MehmetEralpKose/ISWT/Hardware Project/Materials for the Report/Fotos for simulations and test results/Test results/Power supply.jpeg

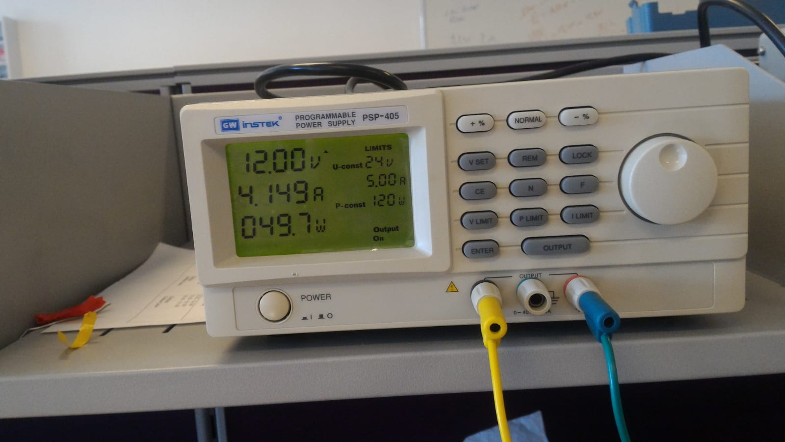
Hardware Project/Materials for the Report/Fotos for simulations and test results/Test results/Power supply.jpeg
