MehmetEralpKose/ISWT/Hardware Project/Materials for the Report/Fotos for simulations and test results/Test results/Vds for 10 ohm.jpeg

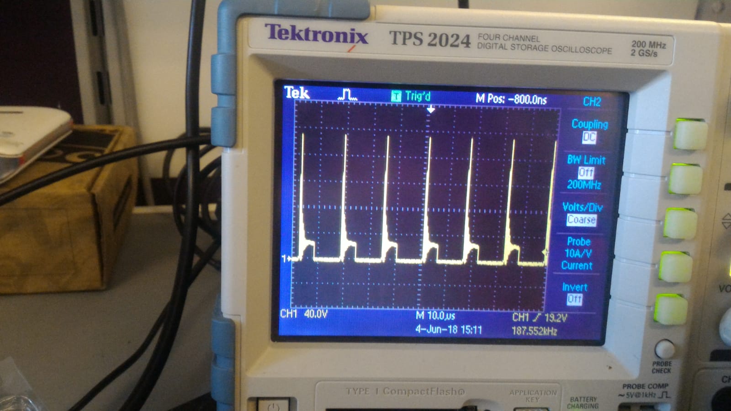
Hardware Project/Materials for the Report/Fotos for simulations and test results/Test results/Vds for 10 ohm.jpeg
