MehmetEralpKose/ISWT/README.md

# ISWT
2017-2018 Spring Term EE 464 Hardware Project Repository
