MehmetEralpKose/ISWT/Simulation Project/Transformer Design_1st version.docx

Transformer Design

We use 495-5251-ND as a core. Its material is N41.

Bsat is nearly 0.4T.


N1>(Vimax*Dmax*1/(fs))/(Bsat*Ae) (1)

From the equation (1) N1>2

Reluctance=(Le)/((µ*Ae)) (2)

R=0.2 Ω

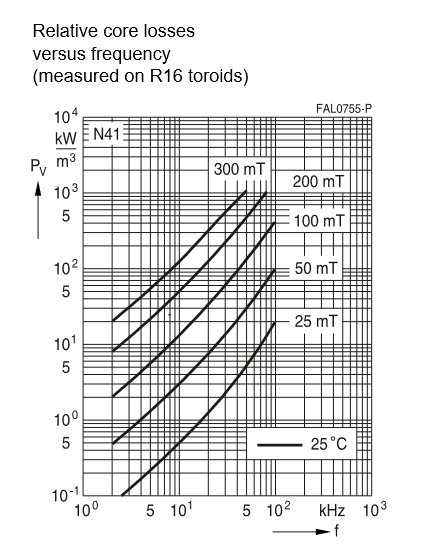
[picture p6: figure]
