MehmetEralpKose/ISWT/Simulation Project/1e.docx

e)


Figure 1: Input Current Waveform under Full-Load Operation

Power input during full load operation is,

, P_(in) =V_s *I_(input) #(1)

, P_(in) =12*17.795*0.4 #(2)

, P_(in) =85.416W #(3)

, efficiency=(P_(out))/(P_(in))=0.93 #(4)

, I_(out) =1.842A #(5)


Figure 2: Input Current Waveform under 75% Load Operation

Power input during full load operation is,

, P_(in) =V_s *I_(input) #(6)

, P_(in) =12*13.73*0.4 #(7)

, P_(in) =65.9W #(8)

, efficiency=(P_(out))/(P_(in))=0.91 #(9)

, I_(out) =1.229A #(10)


Figure 3: Input Current Waveform under 50% Load Operation

Power input during full load operation is,

, P_(in) =V_s *I_(input) #(11)

, P_(in) =12*9.67*0.4 #(12)

, P_(in) =46.416W#(13)

, efficiency=(P_(out))/(P_(in))=0.88 #(14)

, I_(out) =0.8192A #(15)


Figure 4: Input Current Waveform under 25% Load Operation

Power input during full load operation is,

, P_(in) =V_s *I_(input) #(16)

, P_(in) =12*5.42*0.4 #(17)

, P_(in) =26.016W#(18)

, efficiency=(P_(out))/(P_(in))=0.76 #(19)

, I_(out) =0.4079A #(20)

As expected, efficiency is decreased with decreasing load. Due to transformer used in flyback converter, transformer has low efficiency due to hysteresis losses (magnetization and demagnetization of transformer core) and eddy current at low load. Since at low load, these losses dominate the output power. Then the efficiency of the flyback converter is low under smaller loads. When load further increased efficiency will start to increase until its maximum level. Since also all of the components has finite resistance which caused power losses such as internal resistance of the switch, internal resistance of the capacitance etc.
