MehmetEralpKose/ISWT/Simulation Project/Q1-a_edition2.docx

a) , (V_o)/(V_d)=(N_2)/(N_1)*(D/(1-D))#(1)

Let’s assume D=0.4

, 48/12=(N_2)/(N_1)*(0.4/(1-0.4))#(2)

, (N_2)/(N_1)=6#(3)

To find Lm first find the average current flow in Lm

, I_(L_m) =(I_o)/((1-D))*(N_2)/(N_1)=((P_(out))/(V_(out)))/((1-D))*(N_2)/(N_1) #(4)

, I_(L_m) =16.1A #(5)

Now let’s assume, current ripple in the magnetization current is equal to 40%.

, ∆I_(L_m) =16.1*0.4≅6.4#(6)

, L_m =(V_d D)/(∆I_(L_m) f_s)#(7)

fs is taken as 100kHz,

, L_m =7.5μH #(8)

Lm is taken as 14.4 μH , which is explained in part b.

Then, the MATLAB Simulink simulations were done according to values which were found above.

Figure 1:Circuit Schematic of the Flyback Converter


Figure 2: Output Characteristic of the Flyback Converter


Figure 3: Current Flow Characteristic on the Diode


Figure 4: Magnetization Current Waveform of the Flyback Converter
