MehmetEralpKose/ISWT/Simulation Project/Q2/Transfer Function.docx

Q2)

TRANSFER FUNCTION OF FLYBACK CONVERTER


Figure 2.1: Flyback Converter Schematic


Figure 2.2: Small Signal Model of Flyback Converter

We choose n=1 and circuit schematic will be like that;


Figure 2.3: Switch ON State When n=1


Figure 2.4: Switch OFF State When n=1

By looking ON state:

-Vi+R_L *i_L +LiL=0 (1)

CVc*(R+rc)+Vc=0 (2)

By using Eq. (1) and (2)


By looking OFF state:

i_L *R_L +L*iL+R(i_L -C*Vc)=0 (3)

-Vc+R(i_L -C*Vc)-C*Vc*rc=0 (4)

By using Eq. (3) and (4)


V_0 =R(i_L -C*Vc) (5)

V0 = [ R*rc/(R+rc) , R/(R+rc)] [i_L Vc ] (6)

A=AON*D+AOFF*(1-D) (7)

B=BON*D+BOFF*(1-D) (8)

C=CON*D+COFF*(1-D) = [ R*rc/(R+rc) , R/(R+rc)] (10)

T(s)=(V_0)/(V_i)=-CA^(-1) B (11)

By using Eq. (7), (8), (9), (10) and (11),

T(s) is that form.


(12)

(n=turn ratio)

(13)

Where the frequency of negative pole:

(14)

And the frequency of negative pole:


(15)

Angular corner Frequency:

(16)

Damping Ratio:

(17)

Where,

(18)

(19)

(20)

Where,

Wzn=10⁵ rad/s,

Wzp=1580138.9 rad/s,

W0=15866 rad/s,

ξ= 0.3119,

Therefore,

T(s)=0.311*([(s+100000)*(s-1580138.9 )])/(s^2 +9896.25s+251729355.8)

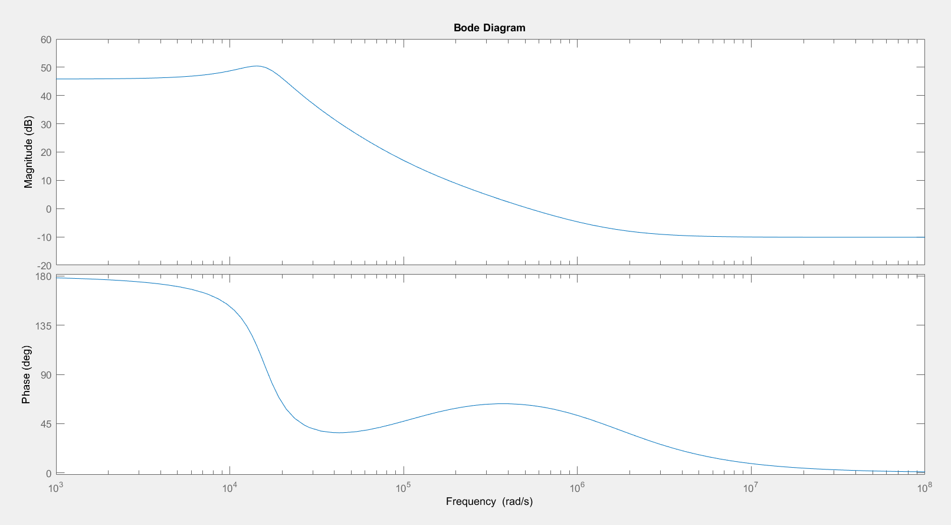
[picture p42: figure]

Bode Plot for 1:1 Turn Ratio

We will use 3:18 turn ratio so transfer function is modified for this turn ratio. Now, n=1/6 and

Wzn=10⁵ rad/s,

Wzp=428317.9 rad/s,

W0=2237.84 rad/s,

ξ= 0.677,

T(s)=0.05188*([(s+100000)*(s-428317.9 )])/(s^2 +3030*s+5007927.9)

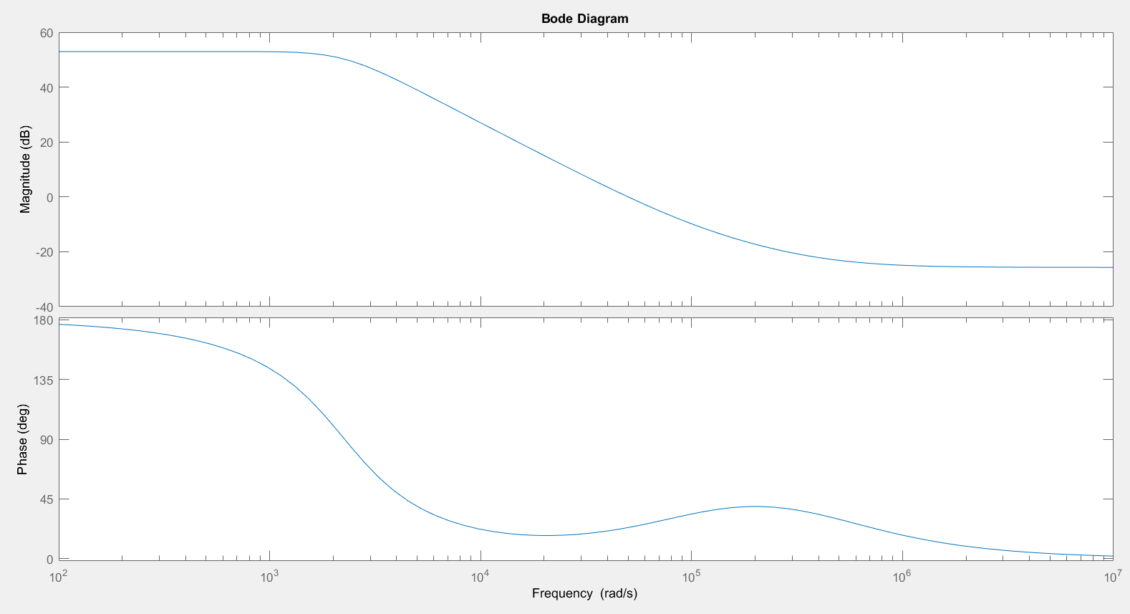
[picture p43: figure]

Bode Plot for 3:18 Turn Ratio
