MehmetEralpKose/ISWT/Simulation Project/Q1-c/25% Load.jpg

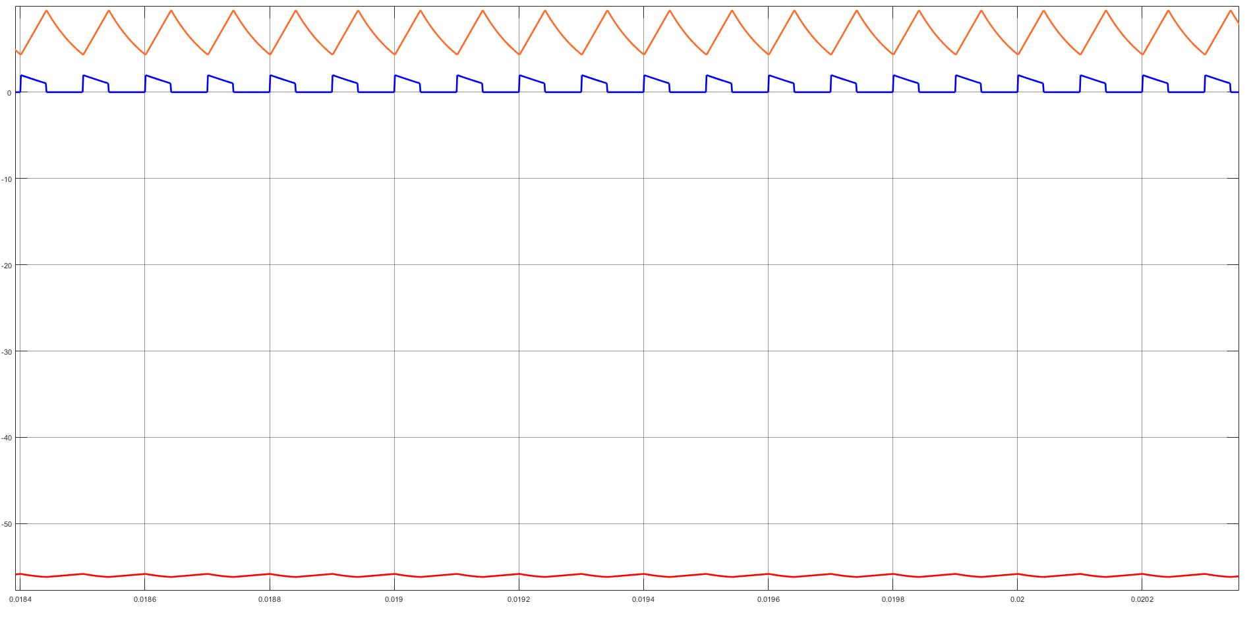
Simulation Project/Q1-c/25% Load.jpg
