MehmetEralpKose/ISWT/Simulation Project/Q1-c/50% load.jpg

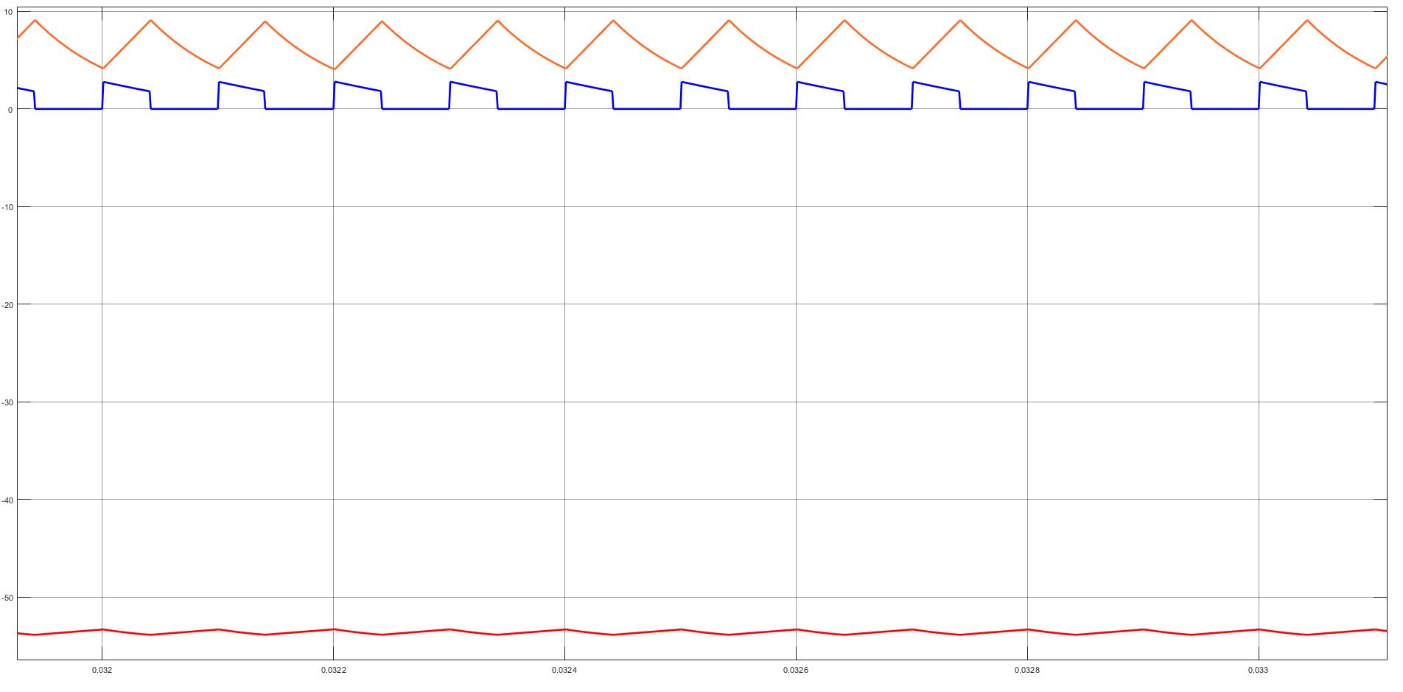
Simulation Project/Q1-c/50% load.jpg
