MehmetEralpKose/ISWT/Simulation Project/Q1-c/75% load.jpg

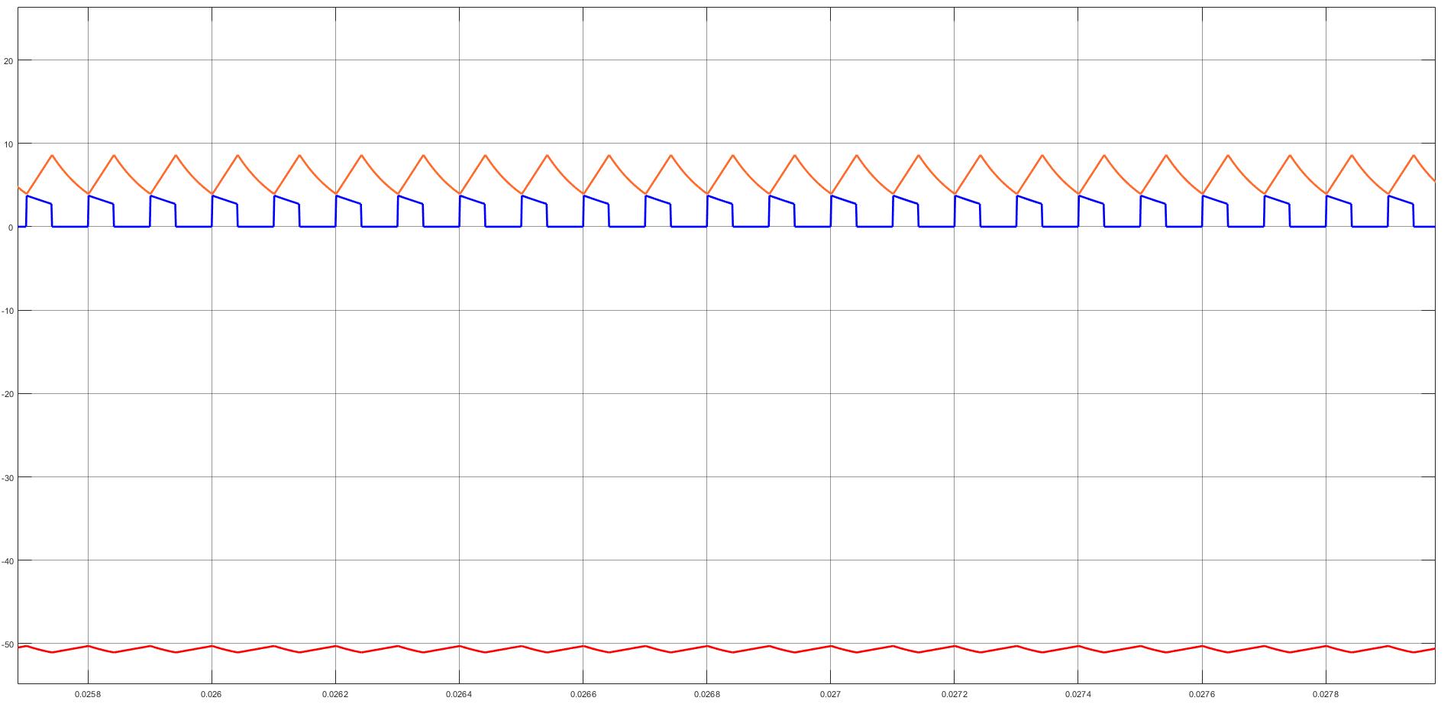
Simulation Project/Q1-c/75% load.jpg
