MehmetEralpKose/ISWT/Simulation Project/Q1-c/100% load.jpg

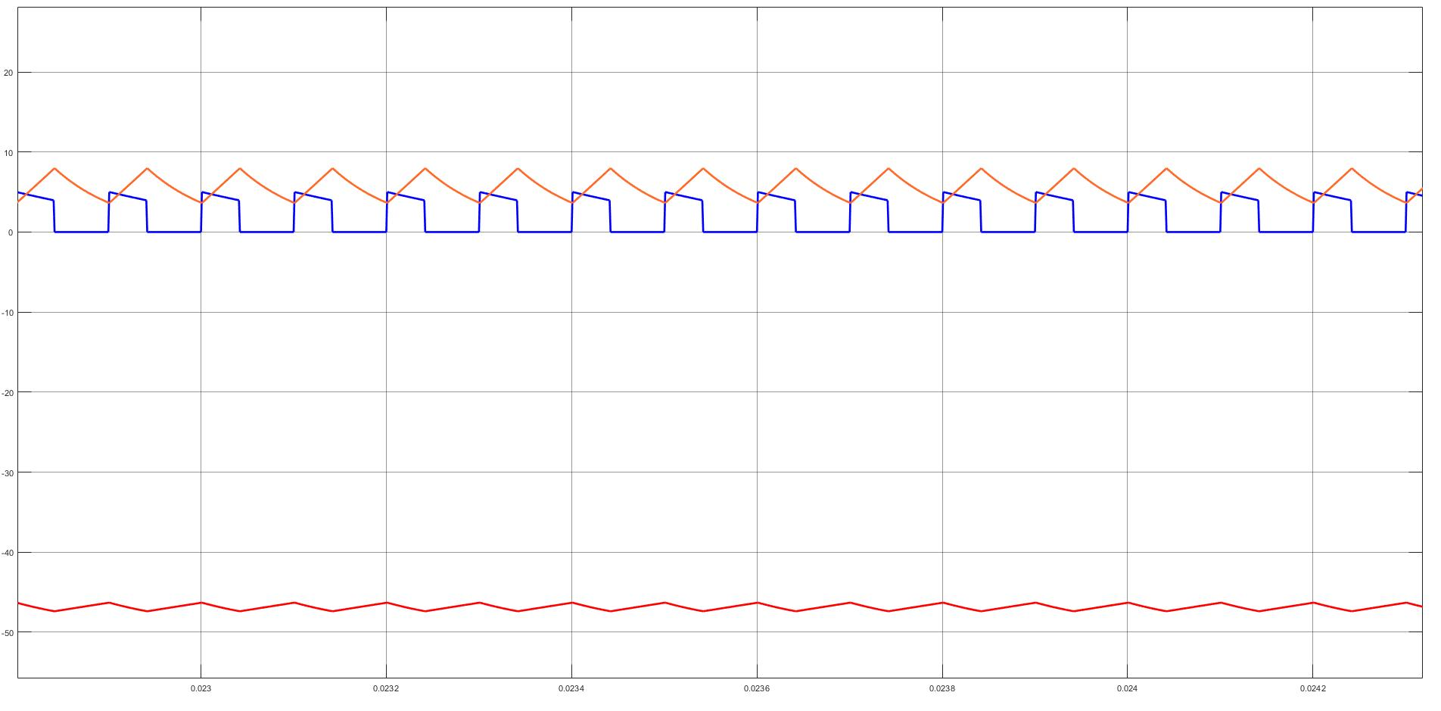
Simulation Project/Q1-c/100% load.jpg
