MehmetEralpKose/ISWT/Simulation Project/Q2/Fotos/Vout when load changing.PNG

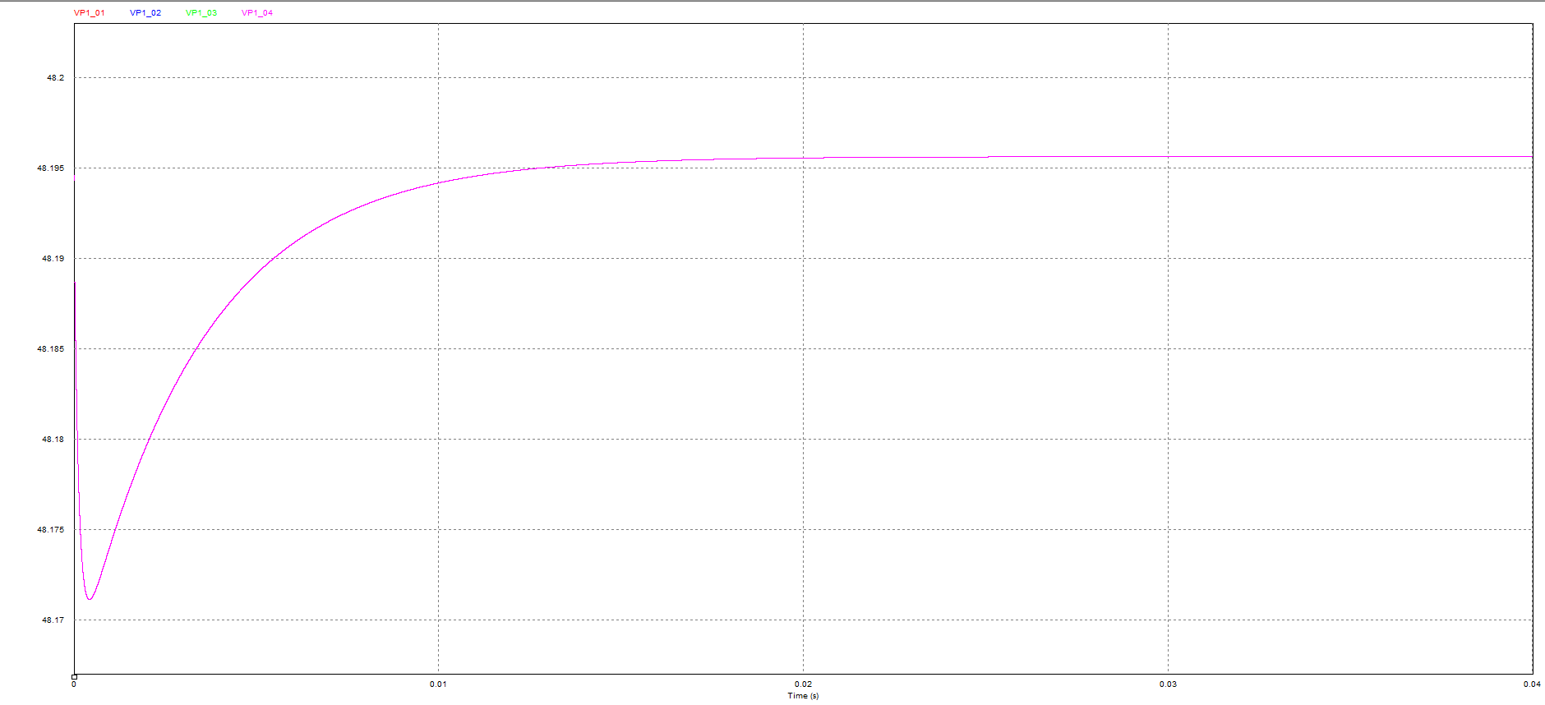
Simulation Project/Q2/Fotos/Vout when load changing.PNG
