MehmetEralpKose/ISWT/Hardware Project/Materials for the Report/cover page.docx

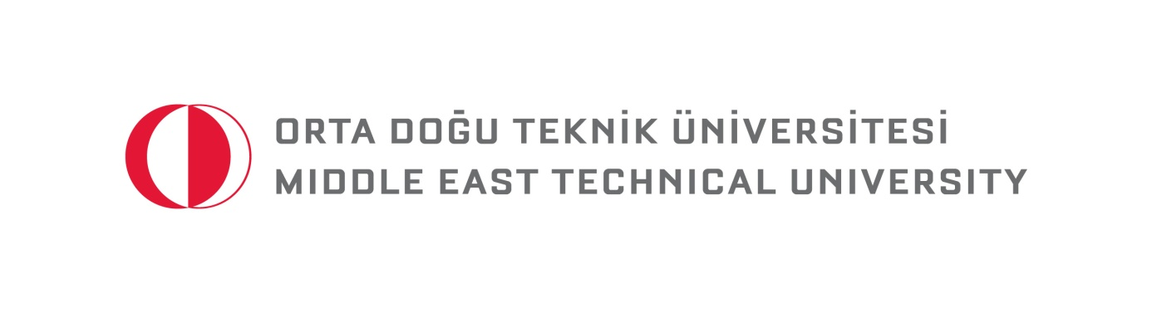
[picture p76: figure]

EE 464

HARDWARE PROJECT

12 V to 48 V Flyback Converter

Muhammed Emin CİNALİOĞLU 2030427

Celal KAVLAK 2030955

Mehmet Eralp KÖSE 2031094

Course Instructor: Ozan KEYSAN

Course Assistant: İlker ŞAHİN
