MehmetEralpKose/ISWT/Hardware Project/Materials for the Report/Losses.docx

Losses

- Snubber: 25.6 W
- MOSFET
  - Conduction loss:

V_(ds) *I_d *D=0.7*12*0.75=6.3W

  - Switching loss:

(t_(d(on)+) t_(d(off)) +t_r +t_f )*(V_(ds))/2*(I_(ds))/2*f_s =

=(23+120+100+94)*10^(-9) *48/2*15/2*62500=3.79W

- Output Diode
  - Conduction loss

V_F *I_o =1*1.67=1.67W

  - Switching loss

(t_(rr) )*(V_R)/2*(I_D)/2*f_s =35*10^(-9) *64/2*6.7*62500=0.47W

Total loss= 25.6+6.3+3.79+1.67+0.47 = 37.83W(except core losses)
