MehmetEralpKose/ISWT/Hardware Project/Selected Components/Selected Components.pdf

100 uF – 100 V output capacitor

10 uF – 250 V Snubber capacitor

1K 25 W Aluminum Resistor for snubber

Arduino UNO
