MehmetEralpKose/ISWT/Hardware Project/Materials for the Report/LOGO.pptx

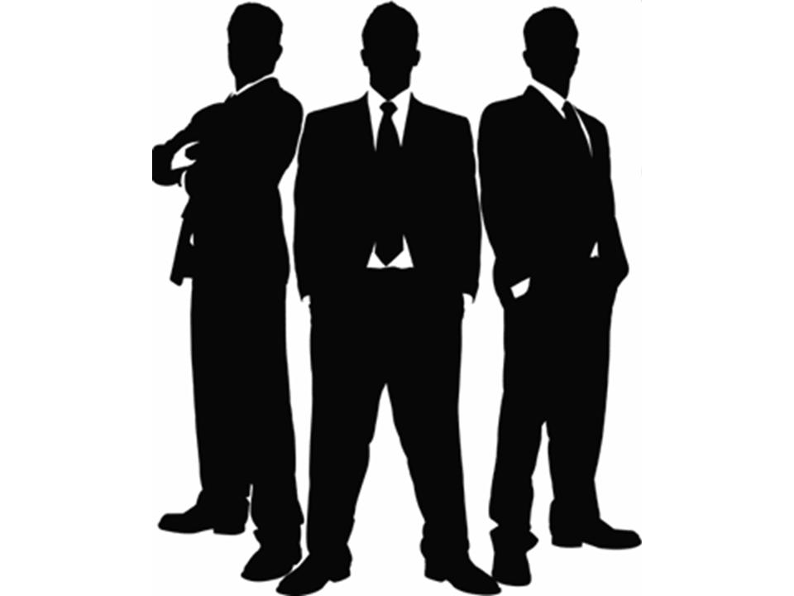
[picture p79: figure]
three man logo ile ilgili gÃ¶rsel sonucu

ISWT
