MehmetEralpKose/ISWT/Hardware Project/Materials for the Report/Fotos for simulations and test results/Test results/Input voltage-current.jpeg

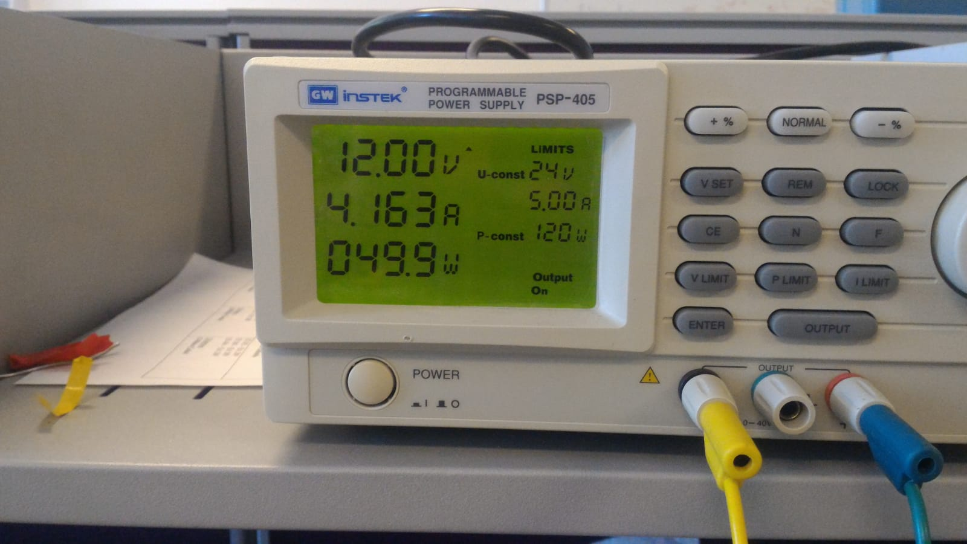
Hardware Project/Materials for the Report/Fotos for simulations and test results/Test results/Input voltage-current.jpeg
