MehmetEralpKose/ISWT/Hardware Project/Materials for the Report/Fotos for simulations and test results/Test results/Output voltage.jpeg

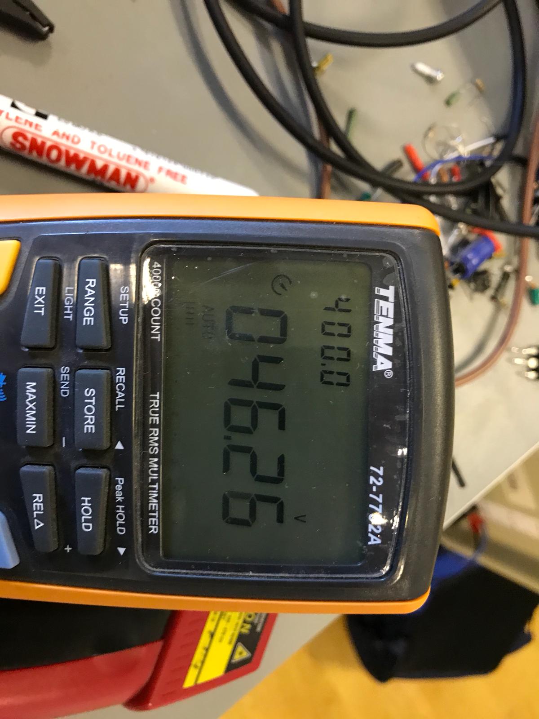
Hardware Project/Materials for the Report/Fotos for simulations and test results/Test results/Output voltage.jpeg
