MehmetEralpKose/ISWT/Hardware Project/Simulations/3748_12-48V_version5.asc

C1: cap; 4700p
C2: cap; 4.7µ
C3: polcap; 100µ; V=100 Irms=1.33 Rser=0.047 Lser=0
C4: cap; 1n
C5: cap; 150p
C6: cap; 10µ; V=4 Irms=8.88 Rser=0.00522854 Lser=0 mfg="KEMET" pn="C0805C106K7PAC" type="X5R"
D1: schottky; 30BQ060
L1: ind2; 6.5µ; Rpar=5K
L2: ind2; 18µ; Rpar=5K
Q1: nmos; IPP200N15N3
R1: res; 66
R2: res; 133k
R3: res; 6.04k
R4: res; 10K
R5: res; 825K
R6: res; 215k
R7: res; 4m
R8: res; 28.8
U1: LT3748
V1: voltage; 12
Named nets: 0, IN, OUT
K1 L1 L2 1.
.tran 20m startup
