MehmetEralpKose/ISWT/Hardware Project/Simulations/3748_no_load.asc

C1: cap; 4700p
C2: cap; 4.7µ
C3: cap; 100µ
C4: cap; .002µ
C5: cap; 10µ
C6: cap; 150p
D1: schottky; 30BQ060
L1: ind2; 22µ; Rpar=5K
L2: ind2; 88µ; Rpar=5K
Q1: nmos; Si4490DY
R1: res; 66
R2: res; 150k
R3: res; 6.04K
R4: res; 10K
R5: res; 825k
R6: res; 215k
R7: res; 30m
U1: LT3748
V1: voltage; 48
Named nets: 0, IN, OUT
K1 L1 L2 1.
.tran 10m startup
