MehmetEralpKose/ISWT/(commit log)

2018-04-16 Question 1-c
    Load yüklerini değiştirerek output voltage, magnetization current ve diode current waveformlarını çıkarttım. Fakat doğrular mı bilemedim.Simulasyon için önceden atmış olduğum flyback modelini kullandım.
2018-04-17 Modification for switching frequency
2018-04-18 Transfer function for buck boost converter
    It is a beneficial thesis to find transfer function for Flyback Converter
2018-04-18 Alternative Buck-Boost Converter Transfer function
    Alternative source
2018-04-18 Psim Simulation Trials
    I have some problems for output voltage, I will deal with it tomorrow
2018-05-09 12V to 48 V at no load
